unibz-makerspace/osp-011-battleship-hid/battleship-attack-grid.pdf

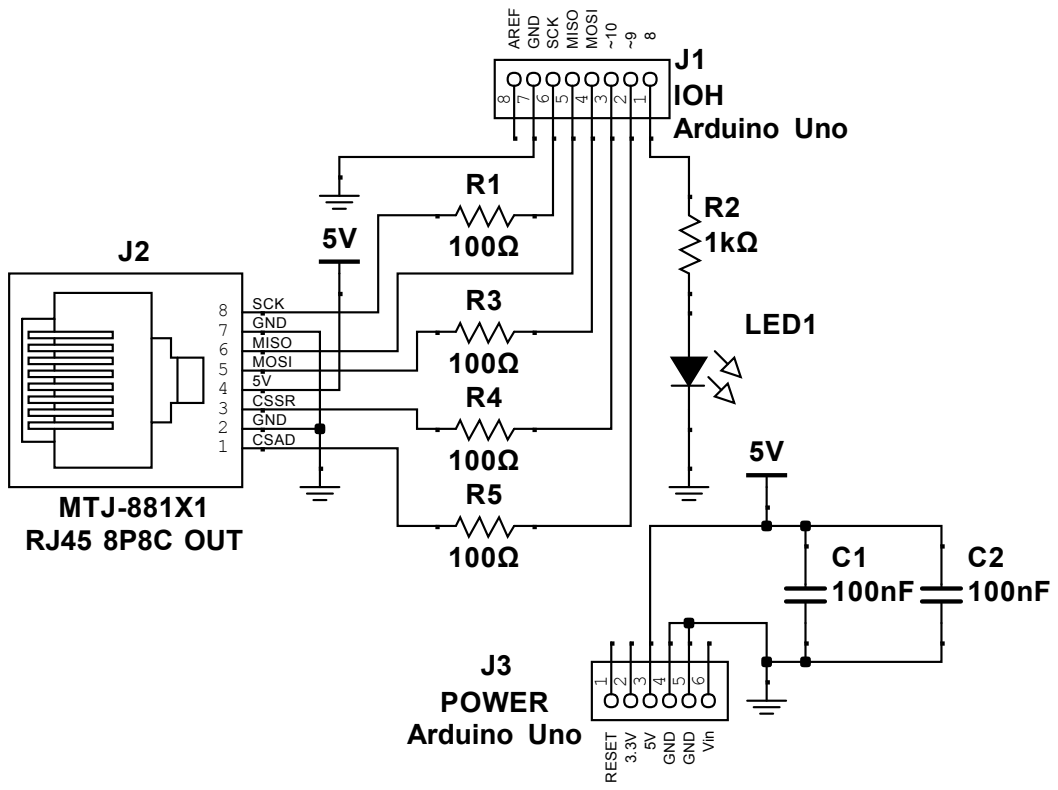
[picture p1: page 1]

battleship-attack-grid#arduino-uno-shield

SC1

## red-row-amplifier

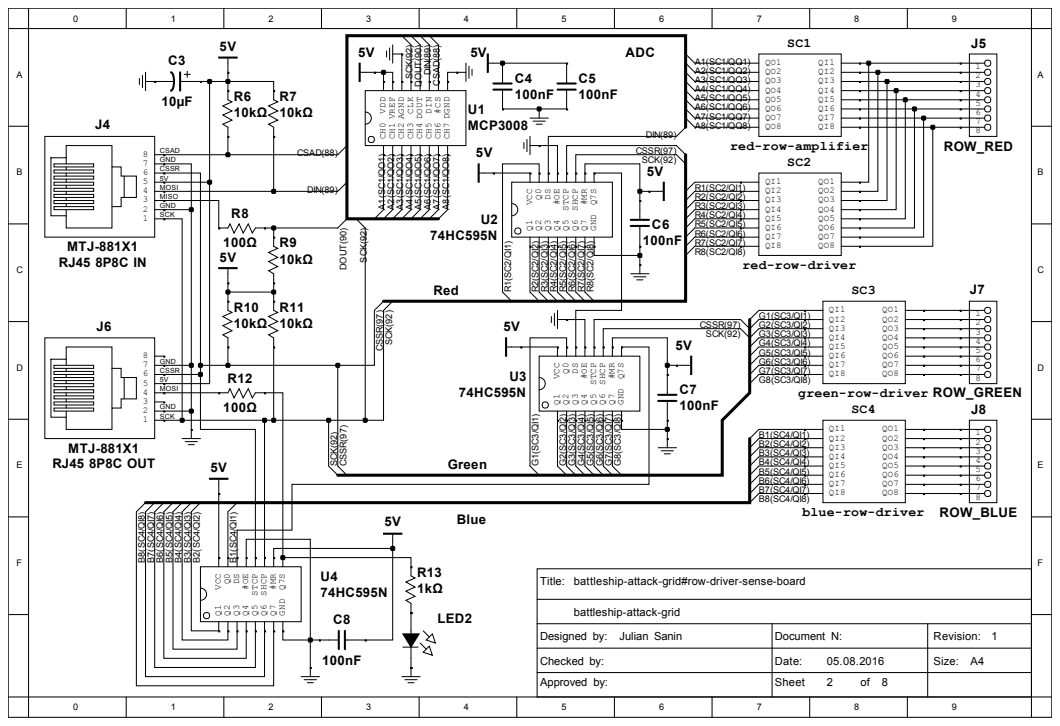
[picture p2: page 2]

battleship-attack-grid#row-driver-sense-board

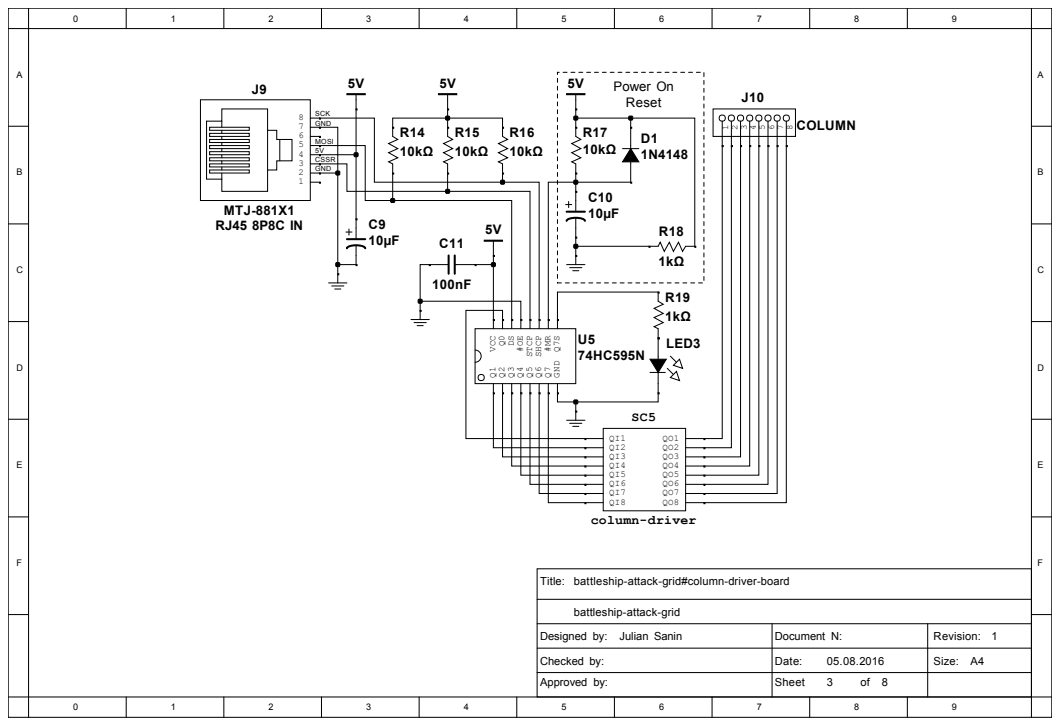
[picture p3: page 3]

battleship-attack-grid#column-driver-board

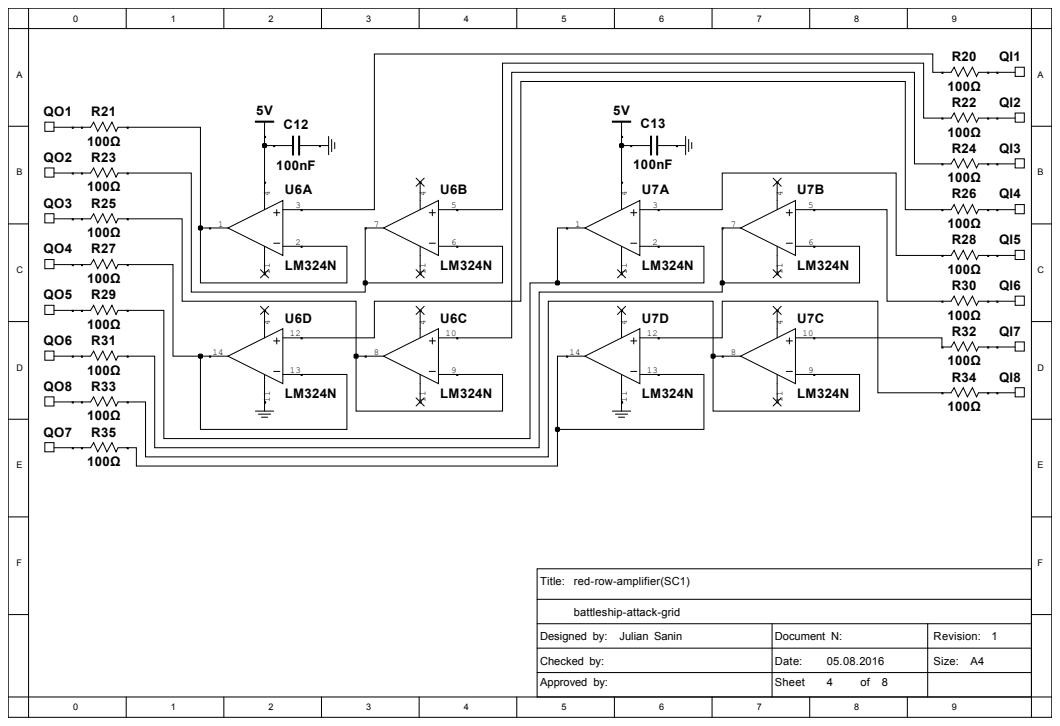
[picture p4: page 4]

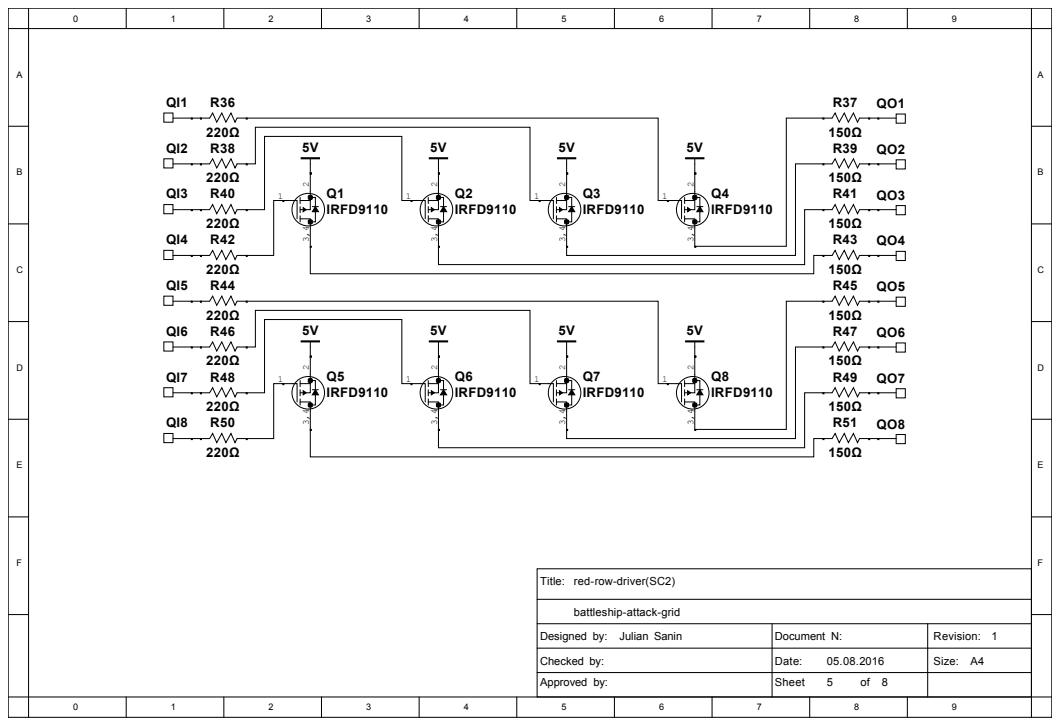
[picture p5: page 5]

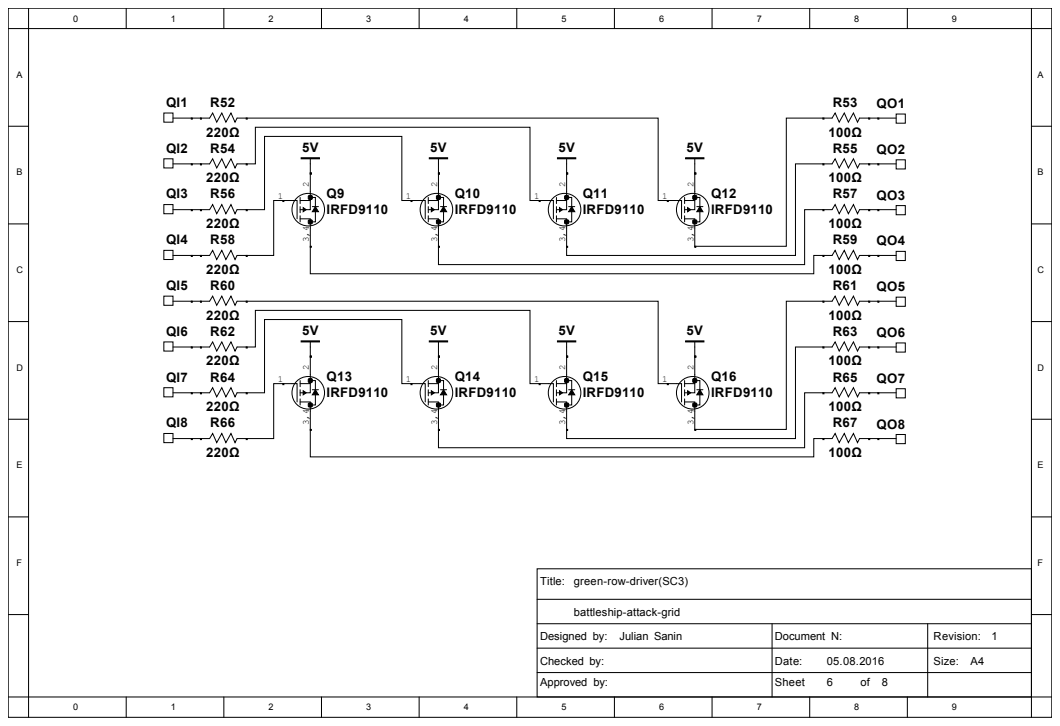
[picture p6: page 6]

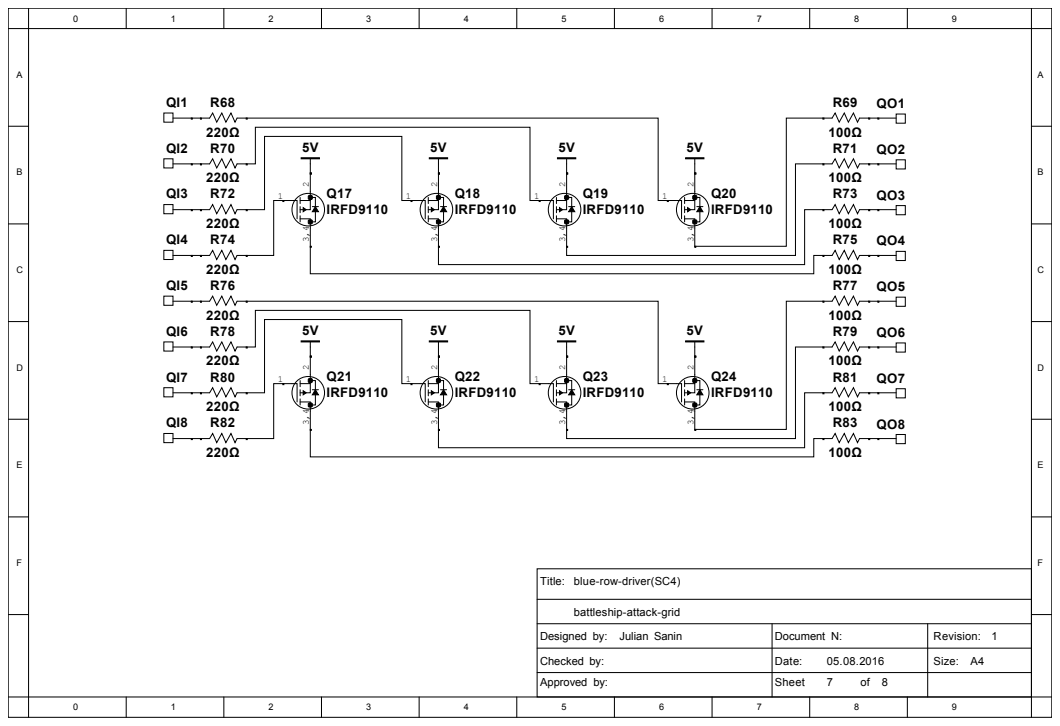
[picture p7: page 7]

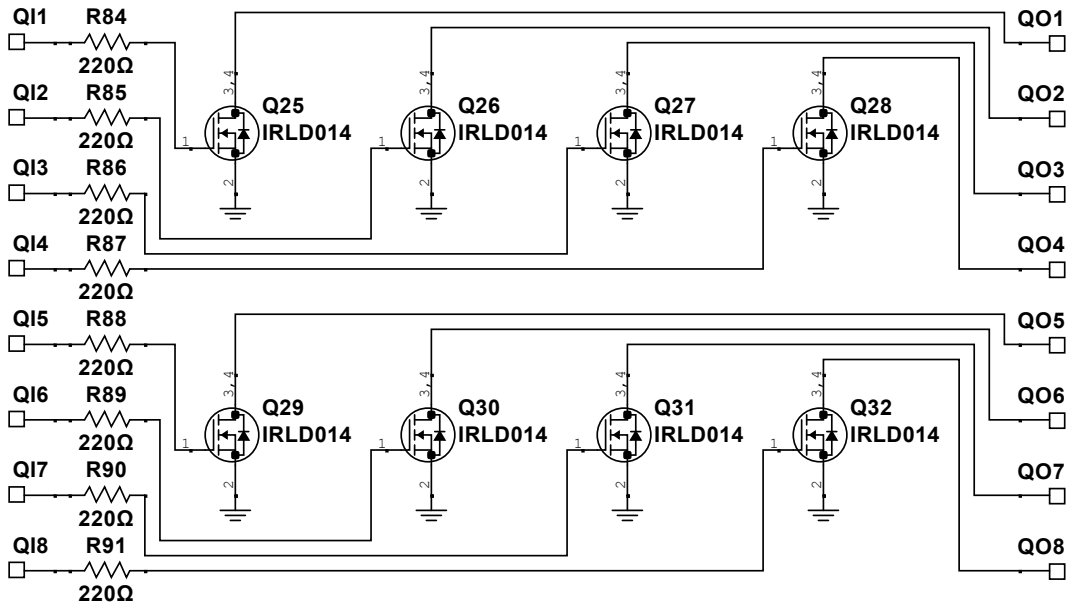
[picture p8: page 8]
