unibz-makerspace/osp-011-battleship-hid/(list of files, drawings)

Other design files:
battleship-attack-grid.ms14
