unibz-makerspace/osp-011-battleship-hid/(commit log)

2016-08-06 Added LED matrix test sketch
2016-08-06 Added circuit design files
    [battleship-attack-grid-bom.xlsx, battleship-attack-grid.ms14]
2016-08-06 Added patent publication of sensing RGB LED matrices
2016-09-24 Added laser calibration sketch
2016-09-29 Updated sensor positions
2016-09-30 Added RGB LED test pattern sketch
